Andy-Hyy/SolarRide/hardware/README.md

# Hardware

[Wiring](../docs/en/hardware.md) · [中文](../docs/zh-CN/hardware.md)

[Box](../docs/en/enclosure.md) · [外壳](../docs/zh-CN/enclosure.md)

PCB file: `pcb/SolarRider_Board_20261012.epro2`
