Andy-Hyy/SolarRide/docs/README.md

# Notes

[English](../README.md) · [中文](../README.zh-CN.md)

| | English | 中文 |
| --- | --- | --- |
| Wiring | [hardware](en/hardware.md) | [硬件](zh-CN/hardware.md) |
| Power | [power](en/power-wiring.md) | [供电](zh-CN/power-wiring.md) |
| Box | [enclosure](en/enclosure.md) | [外壳](zh-CN/enclosure.md) |
| Firmware | [firmware](en/firmware.md) | [固件](zh-CN/firmware.md) |
| Direction | [calibration](en/calibration.md) | [方向](zh-CN/calibration.md) |
| Lights | [operation](en/operation.md) | [灯](zh-CN/operation.md) |
| Bluetooth | [bluetooth](en/bluetooth.md) | [蓝牙](zh-CN/bluetooth.md) |
| Faults | [troubleshooting](en/troubleshooting.md) | [排障](zh-CN/troubleshooting.md) |
