Andy-Hyy/SolarRide/hardware/pcb/README.md

# PCB

`SolarRider_Board_20261012.epro2` contains two PCB pages. The photographs correspond to the page with 16 pins on each side.

[PCB1_20260626_Gerbers.zip](fabrication/PCB1_20260626_Gerbers.zip) contains 13 Gerber layers and two drill files, exported in June 2026.

`SolarRider_Board_20261012.epro2` 含两页 PCB。照片对应每侧 16 针的页面。

[PCB1_20260626_Gerbers.zip](fabrication/PCB1_20260626_Gerbers.zip) 含 13 层 Gerber 与两个钻孔文件，导出于 2026 年 6 月。

[Power](../../docs/en/power-wiring.md) · [供电](../../docs/zh-CN/power-wiring.md)
