Andy-Hyy/SolarRide/docs/assets/README.md

# Images

- `bicycle-mounted.jpg`, `controller-assembled.jpg`: photos
- `enclosure-*.png`: STEP renders
- `power-wiring.svg`: power terminals
- `system-overview.svg`: remote, controller, lights, and the power path
