Andy-Hyy/SolarRide/docs/en/enclosure.md

# Box

[中文](../zh-CN/enclosure.md) · [Home](../../README.md)

| Files | Geometry | Printed |
| --- | --- | --- |
| `盒盖.stp` + `后盖.stp` | Enclosure and flat rear plate, eight screw posts | Printed |
| `盒盖A.stp` + `后盖A.stp` | Enclosure and U-shaped frame | Not printed |

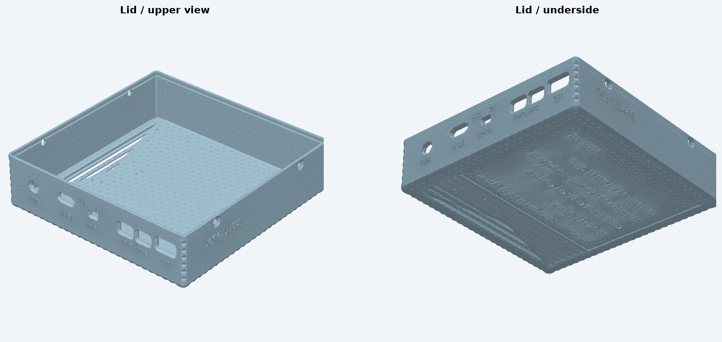
[picture p3: docs/assets/enclosure-lid.png]
Main box


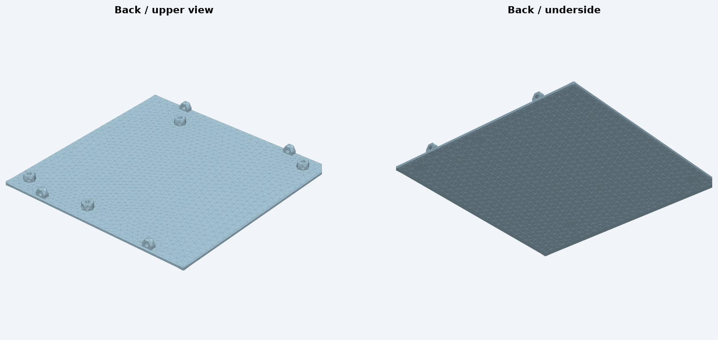
[picture p4: docs/assets/enclosure-back.png]
Rear plate


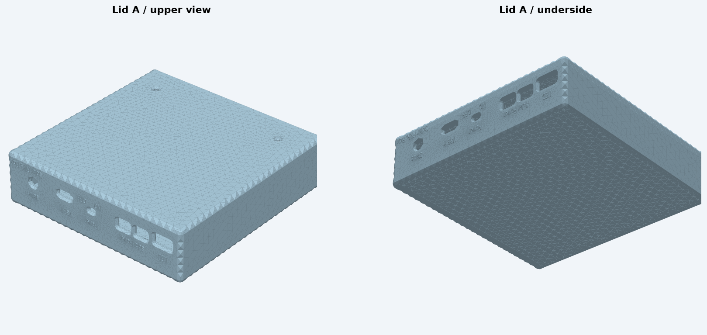
[picture p5: docs/assets/enclosure-lid-a.png]
A box


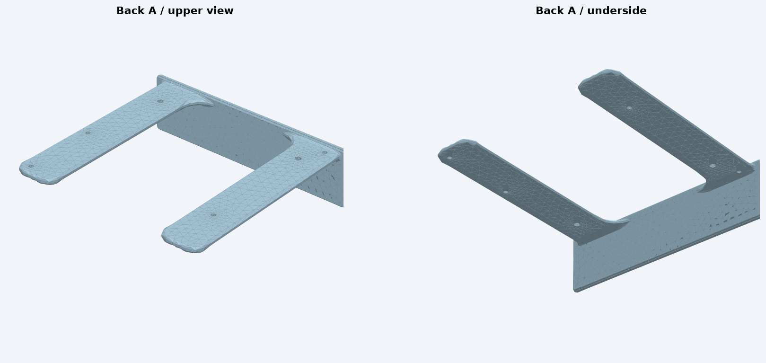
[picture p6: docs/assets/enclosure-back-a.png]
A frame


The images above are renders of the STEP models.
