Andy-Hyy/SolarRide/docs/zh-CN/enclosure.md

# 外壳

[English](../en/enclosure.md) · [首页](../../README.zh-CN.md)

| 文件 | 结构 | 打印 |
| --- | --- | --- |
| `盒盖.stp` + `后盖.stp` | 盒体与平板后盖，八个螺丝柱 | 已打印 |
| `盒盖A.stp` + `后盖A.stp` | 盒体与 U 形外框 | 未打印 |

主盒

后盖

A 盒

A 外框

以上图片为 STEP 模型的渲染。
