Andy-Hyy/SolarRide/hardware/enclosure/盒盖.stp

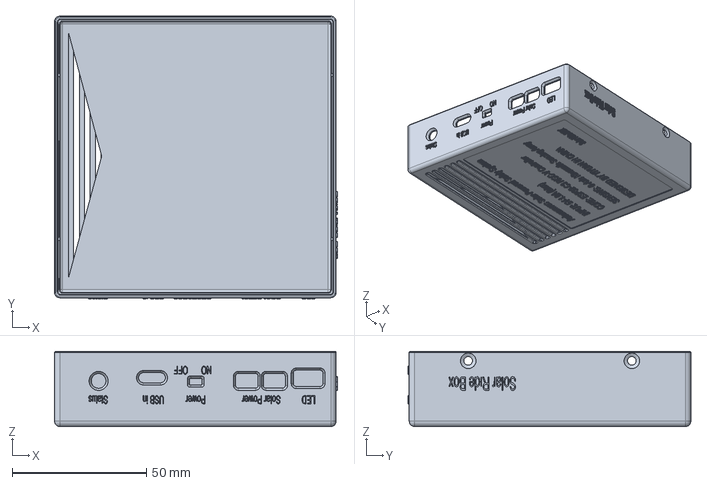
[picture p7: CAD file, 2026-10-12]
hardware/enclosure/盒盖.stp
105.5 x 105.4 x 28.0 mm
