Andy-Hyy/SolarRide/hardware/enclosure/盒盖A.stp

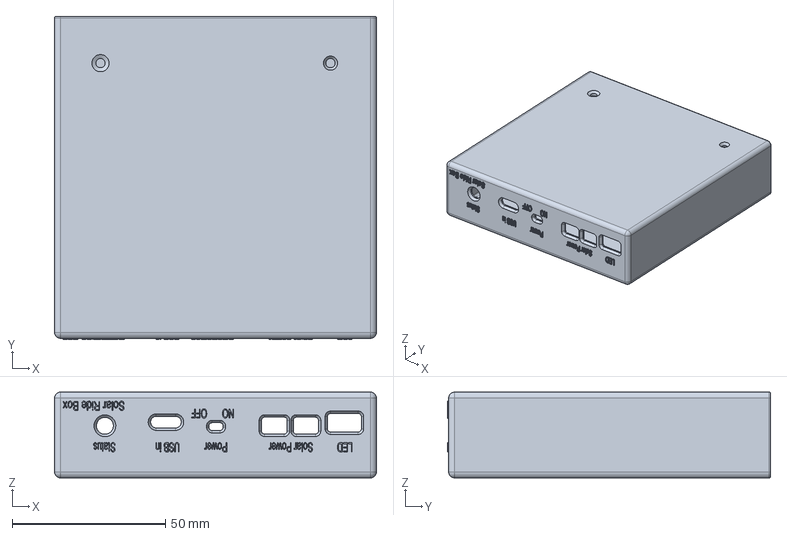
[picture p8: CAD file, 2026-10-12]
hardware/enclosure/盒盖A.stp
105.0 x 105.4 x 28.0 mm
