Andy-Hyy/SolarRide/hardware/enclosure/后盖A.stp

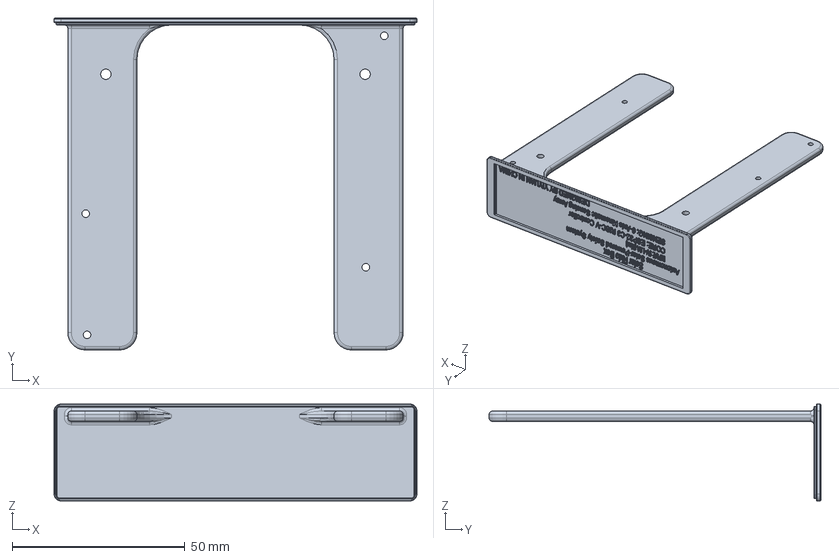
[picture p9: CAD file, 2026-10-12]
hardware/enclosure/后盖A.stp
105.0 x 96.0 x 28.0 mm
