Andy-Hyy/SolarRide/hardware/enclosure/后盖.stp

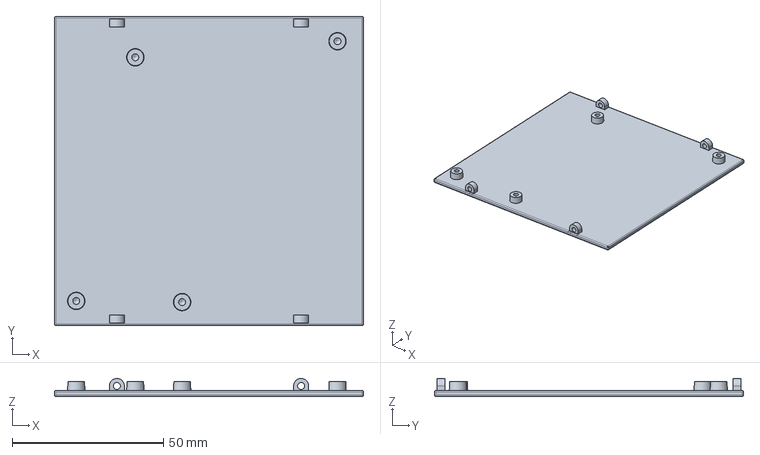
[picture p10: CAD file, 2026-10-12]
hardware/enclosure/后盖.stp
102.3 x 102.3 x 6.00 mm
