Andy-Hyy/SolarRide/docs/en/power-wiring.md

# Power

[中文](../zh-CN/power-wiring.md) · [Home](../../README.md) · [Wiring](hardware.md)

Power connections

| From | To |
| --- | --- |
| Both panels, same polarity | CN3163 SOLAR, parallel |
| CN3163 BAT | Cell |
| 4056-TP BAT | Same cell |
| USB-C | 4056-TP Type-C input |
| 4056-TP OUT | XR2981 IN |
| XR2981 OUT | ESP32 5 V |

The XR2981 input comes from the 4056-TP output, not from the cell. The output was measured at 5 V before the ESP32 was connected. Cell negative is not tied to the 4056-TP output negative.
