Andy-Hyy/SolarRide/firmware/SolarRider_BLE_OTA_V6_5_20261011/OTAPairing.example.h

#pragma once
#include <stdint.h>
// Copy this file to OTAPairing.h, put in your own six-digit PIN,
// and remove the #error below. Do not commit OTAPairing.h.
// 把本文件复制为 OTAPairing.h，填上自己的六位配对码，并删掉下面的 #error。不要提交 OTAPairing.h。
#error "Configure a private BLE pairing PIN before building / 请先设置私有蓝牙配对码"
static constexpr uint32_t solarOTAPairingPIN = 0;
