Andy-Hyy/SolarRide/(commit log)

2026-10-12 放上固件、电路板、外壳和照片
    [后盖.stp, 后盖A.stp, 盒盖.stp, 盒盖A.stp]
2026-10-12 名字改成 SolarRide
    固件目录、蓝牙广播名和电路板文件名仍用原来的。
2026-10-12 记下 10 月 11 日查过的项目
    遥控、刹车和一次采集写在说明里。续航和太阳能充电电流还没测。
2026-10-12 留下固件、硬件和说明
    配对码文件继续忽略。
2026-10-12 更新说明和配对示例
2026-10-12 说明改成接线和记录
2026-10-12 加上中文首页
2026-10-12 更新中英文说明
    引脚、供电和 10 月 11 日的检查记录没有改。
2026-10-15 去掉 .gitignore
